docdailey/bobcat-300/img/bobcat-neo-pinmap.png

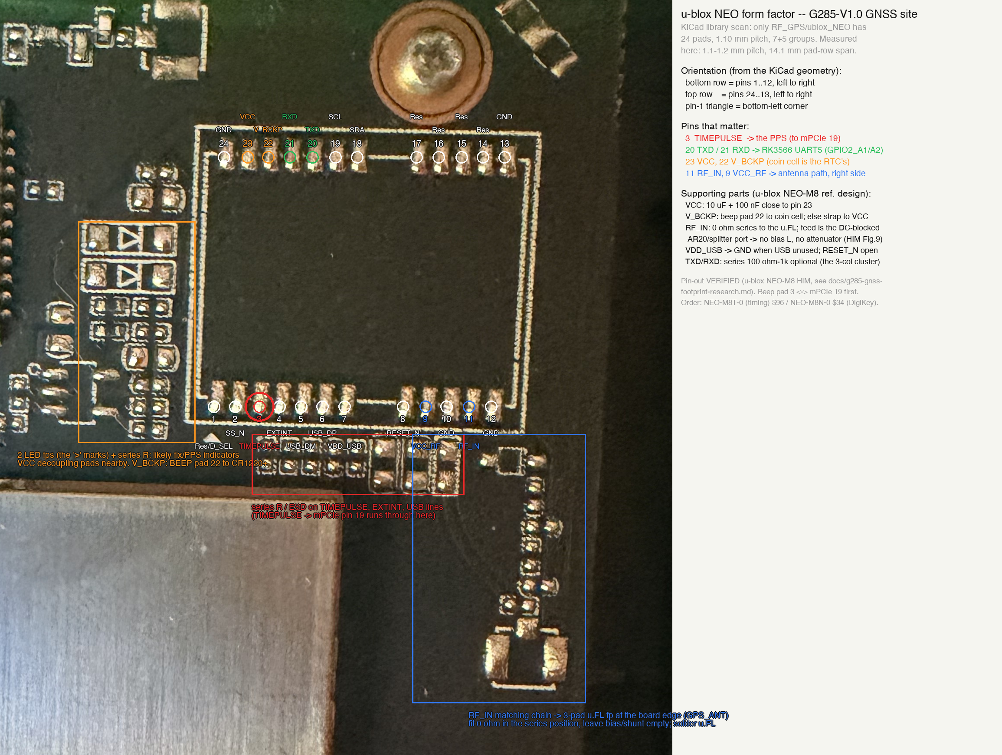
img/bobcat-neo-pinmap.png
