docdailey/bobcat-300/img/bobcat-placement-map.png

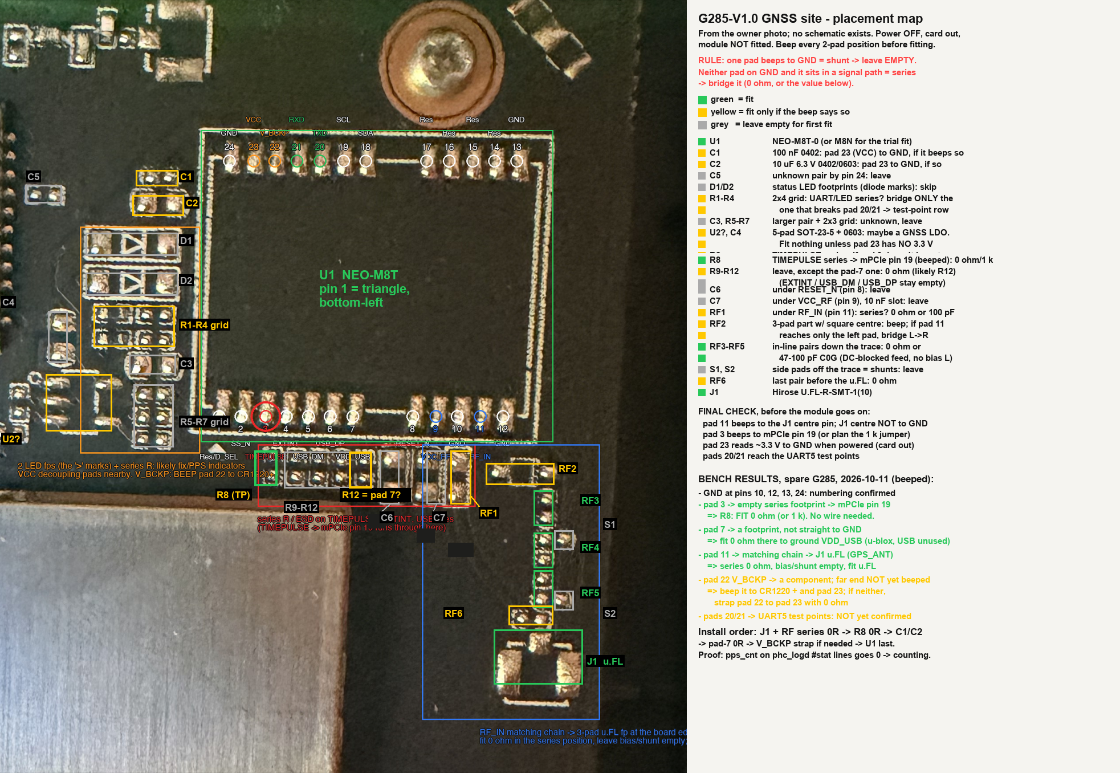
img/bobcat-placement-map.png
