docdailey/bobcat-300/img/socket-resistor-column.jpg

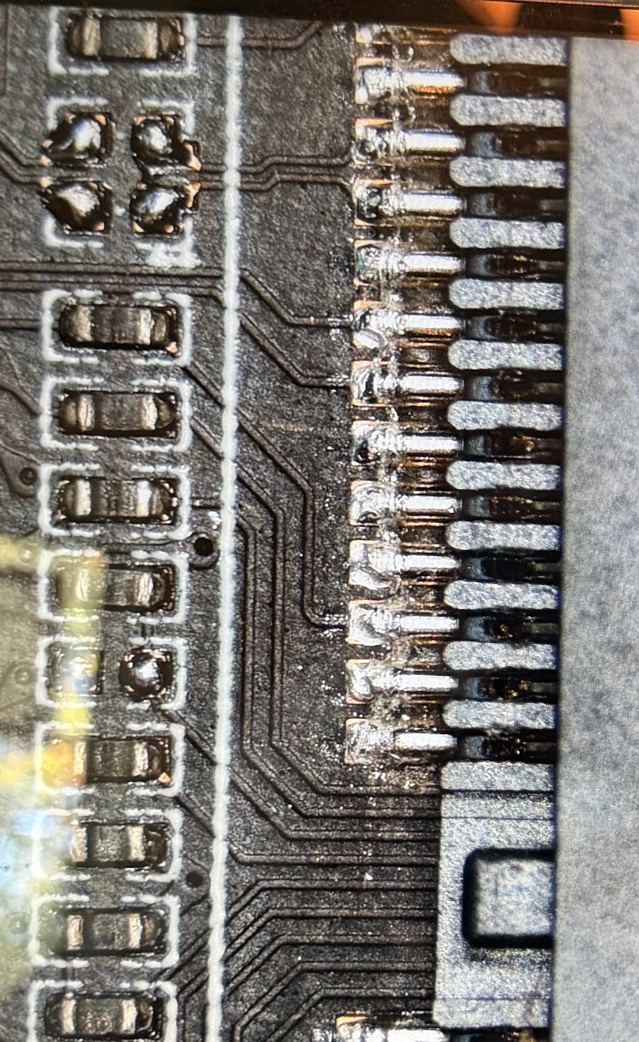
img/socket-resistor-column.jpg
