docdailey/bobcat-300/img/socket-tail-map.png

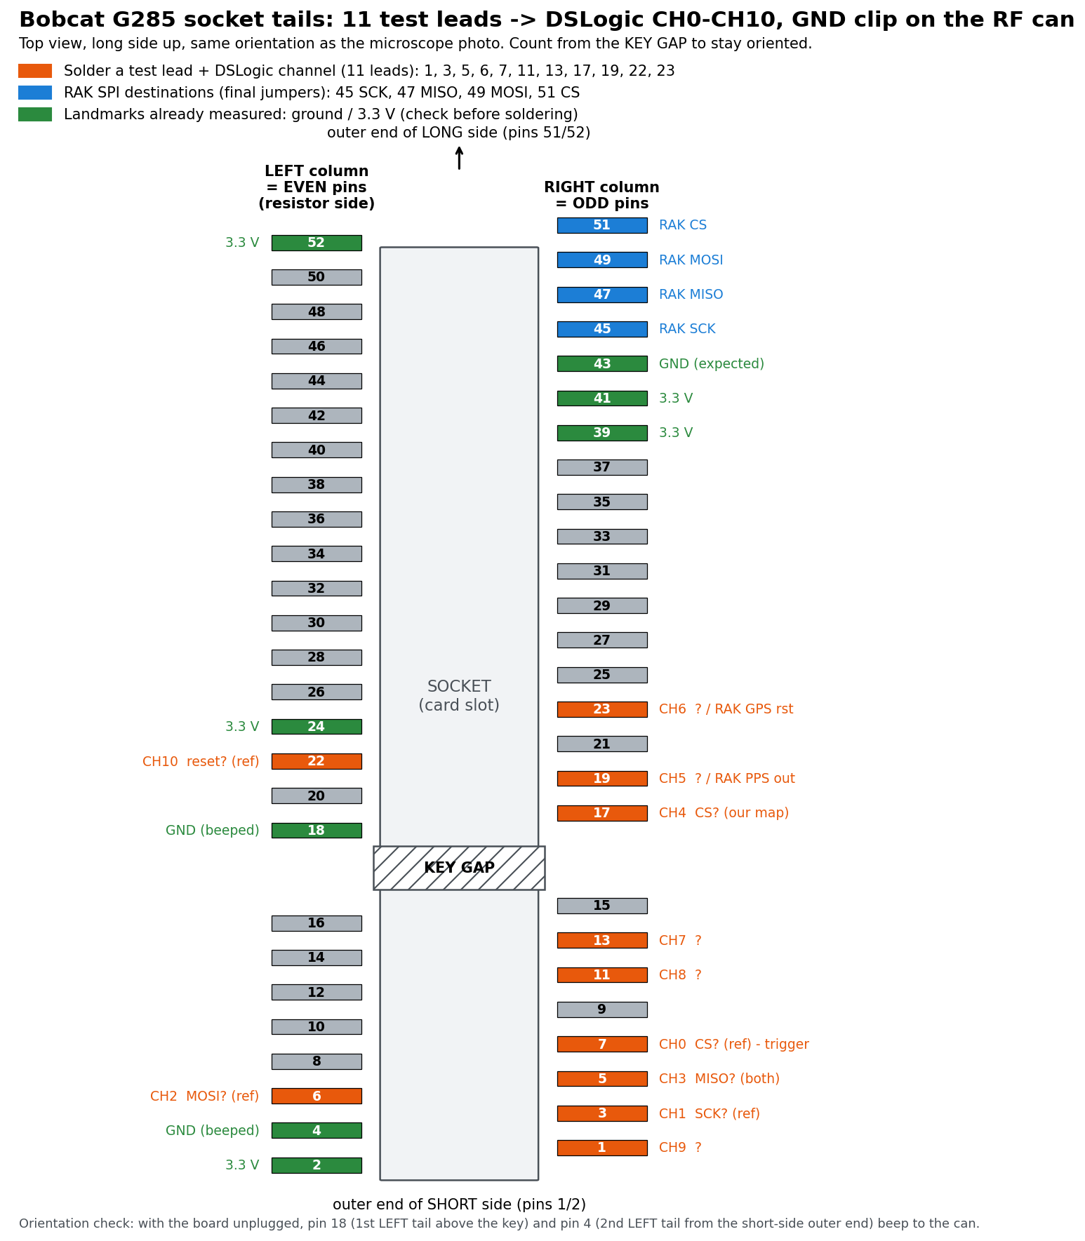
img/socket-tail-map.png
