docdailey/bobcat-300/interposer-rev-a/renders/bobcat-rak-interposer-3d-bottom.png

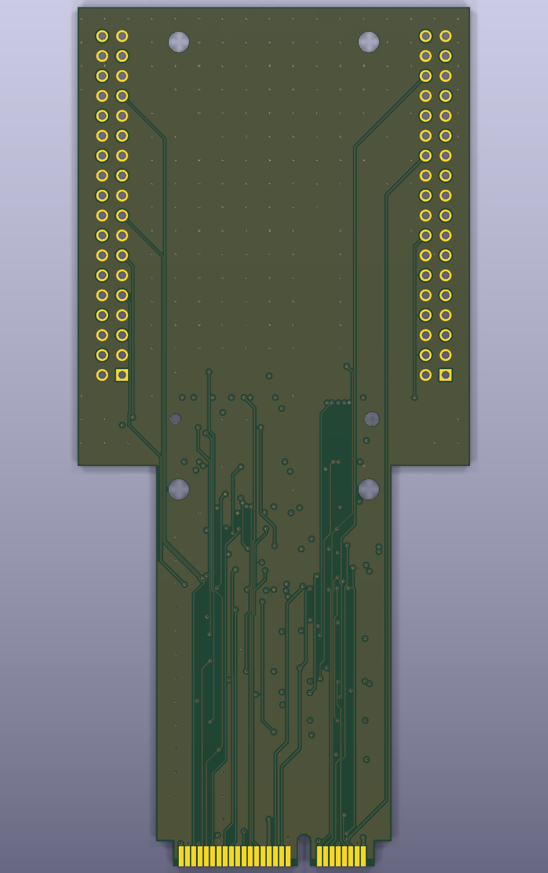
interposer-rev-a/renders/bobcat-rak-interposer-3d-bottom.png
