docdailey/bobcat-300/interposer-rev-a/renders/bobcat-rak-interposer-3d-top.png

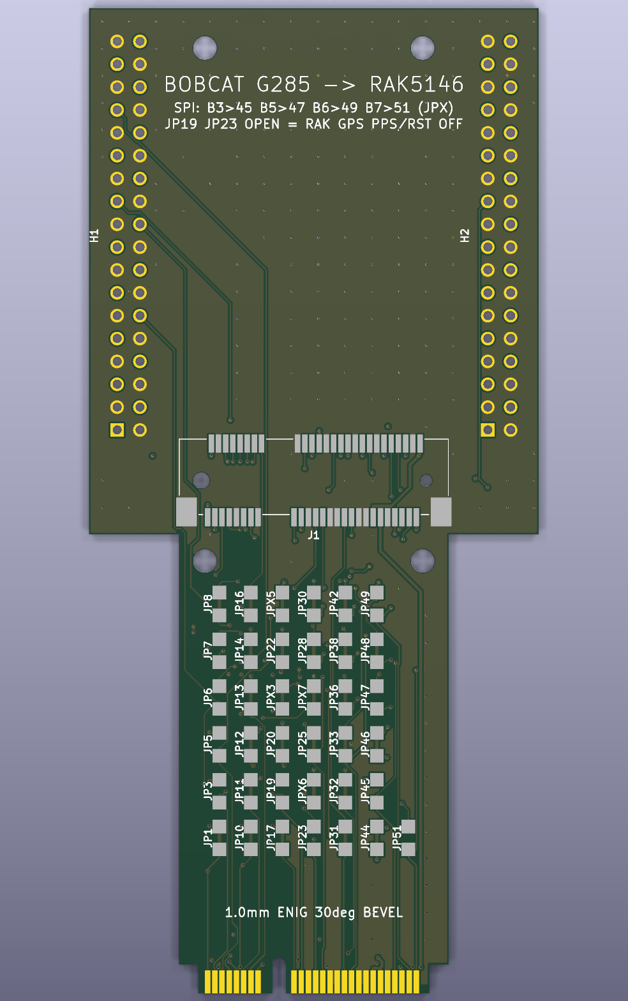
interposer-rev-a/renders/bobcat-rak-interposer-3d-top.png
