docdailey/bobcat-300/interposer-rev-a/renders/bobcat-rak-interposer-pcb-bottom.png

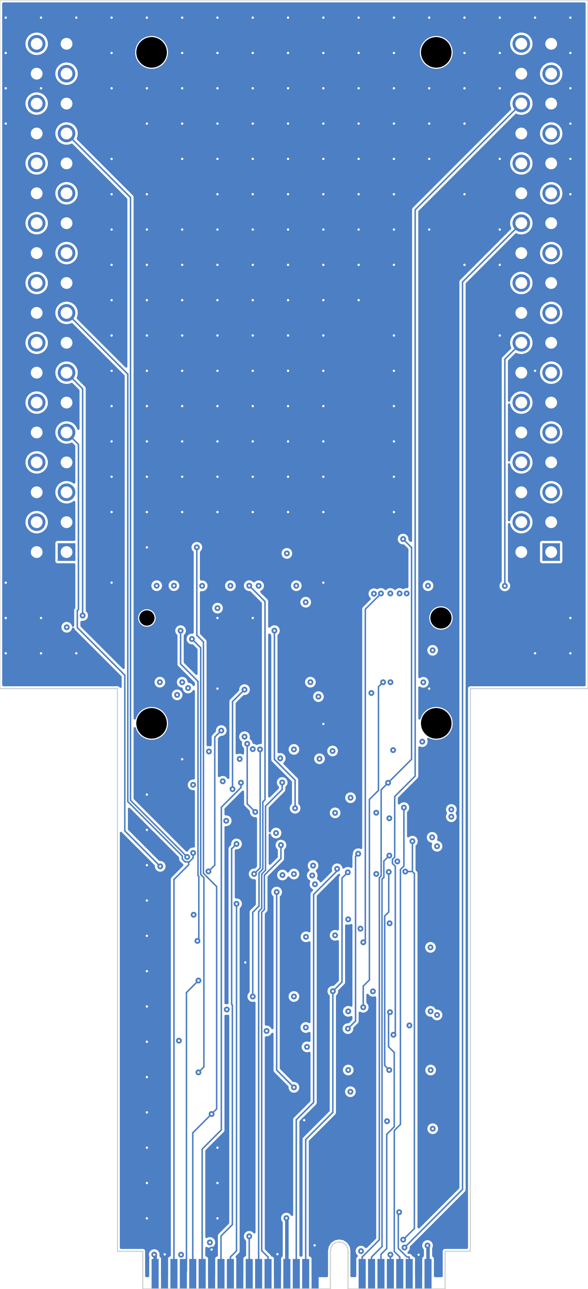
interposer-rev-a/renders/bobcat-rak-interposer-pcb-bottom.png
