docdailey/bobcat-300/interposer-rev-a/renders/bobcat-rak-interposer-pcb-in1-gnd.png

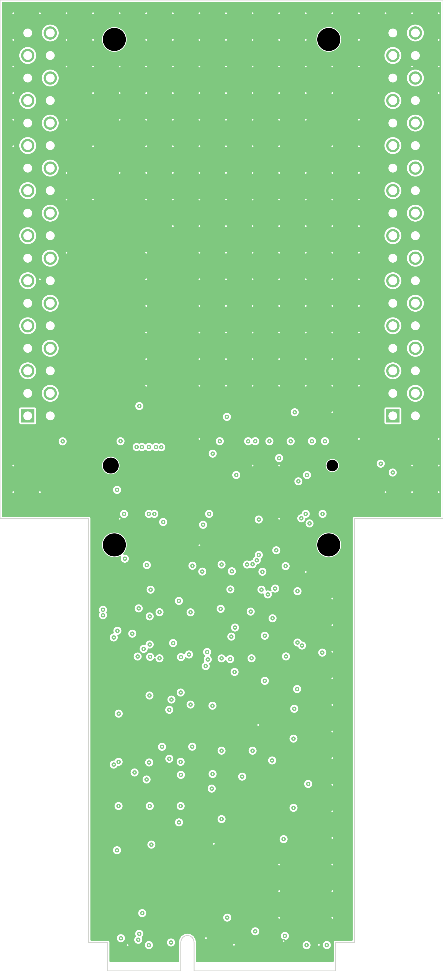
interposer-rev-a/renders/bobcat-rak-interposer-pcb-in1-gnd.png
