docdailey/bobcat-300/interposer-rev-a/renders/bobcat-rak-interposer-pcb-top.png

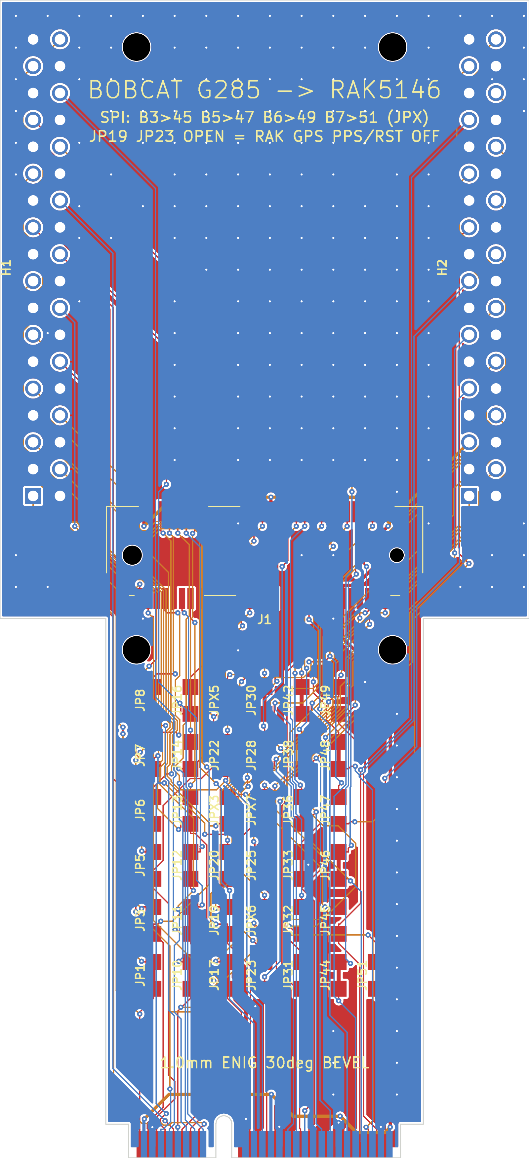
interposer-rev-a/renders/bobcat-rak-interposer-pcb-top.png
