docdailey/bobcat-300/interposer-rev-a/renders/bobcat-rak-interposer-schematic.png

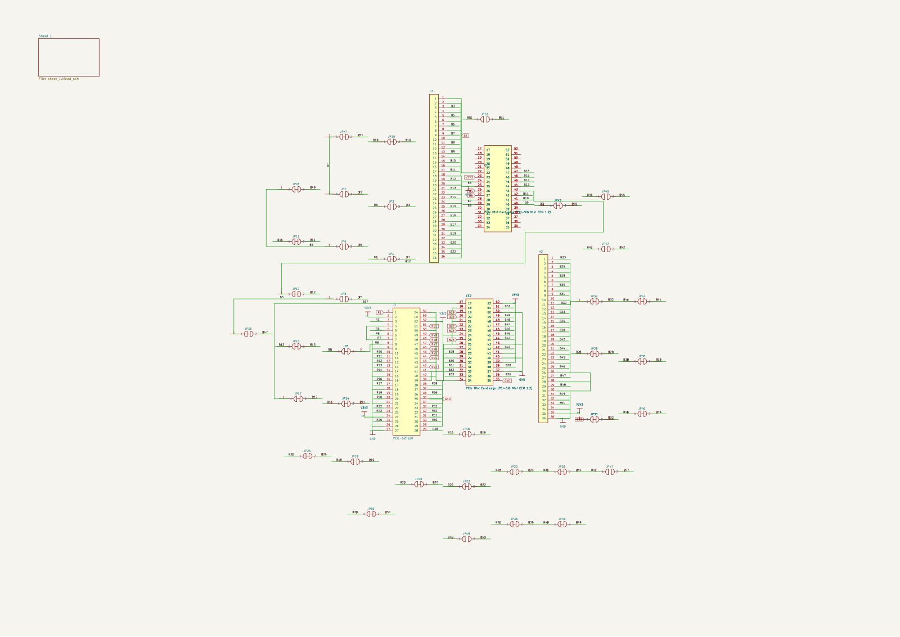
interposer-rev-a/renders/bobcat-rak-interposer-schematic.png
