docdailey/bobcat-300/stack-adapter/fab/panel/bobcat-rak-stack-adapter-panel-3d-top.png

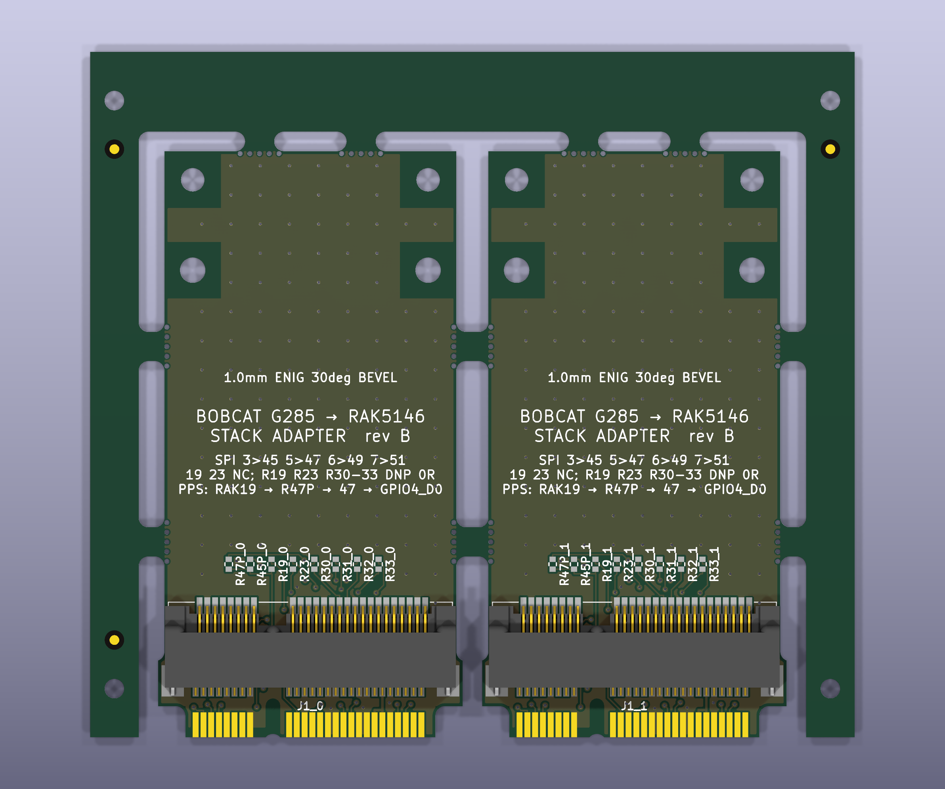
stack-adapter/fab/panel/bobcat-rak-stack-adapter-panel-3d-top.png
