docdailey/bobcat-300/stack-adapter/fab/panel/bobcat-rak-stack-adapter-panel-top.png

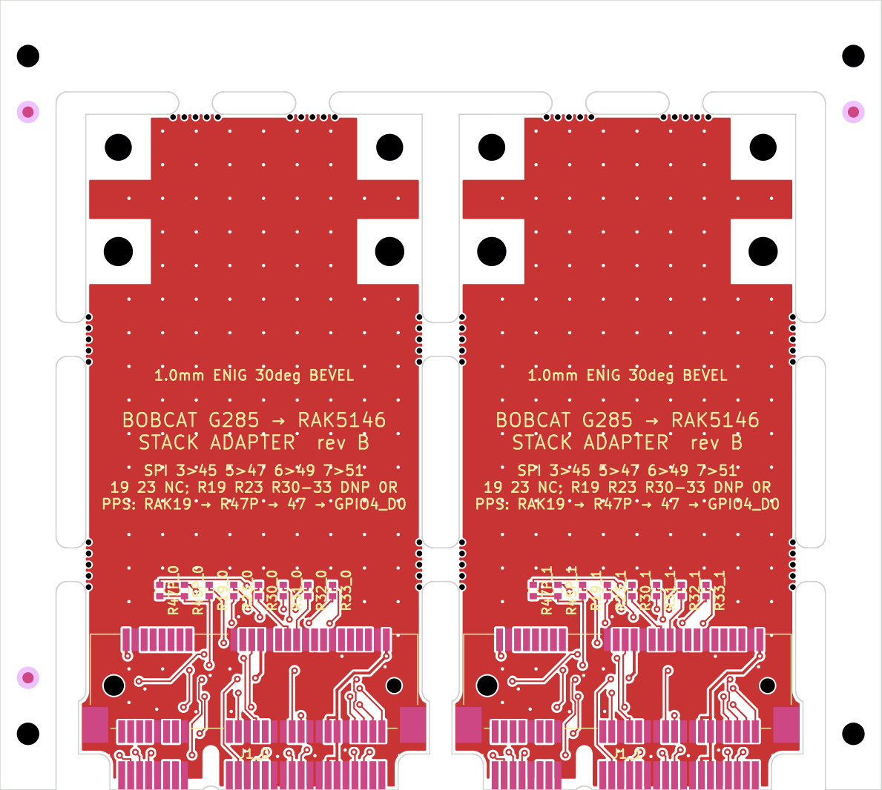
stack-adapter/fab/panel/bobcat-rak-stack-adapter-panel-top.png
