docdailey/bobcat-300/stack-adapter/renders/bobcat-rak-stack-adapter-3d-bottom.png

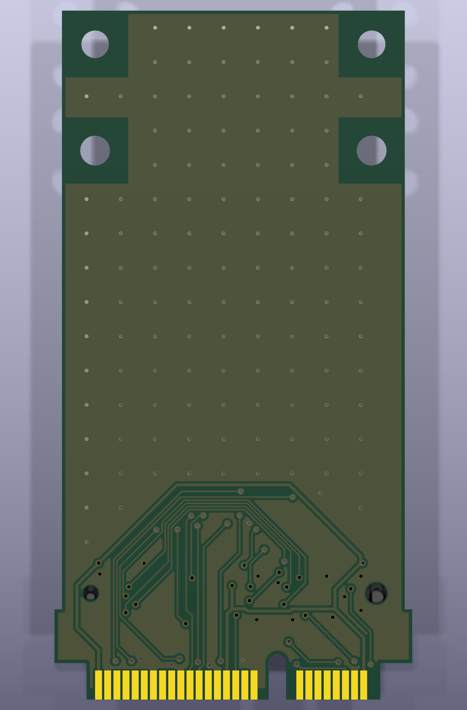
stack-adapter/renders/bobcat-rak-stack-adapter-3d-bottom.png
