docdailey/bobcat-300/stack-adapter/renders/bobcat-rak-stack-adapter-3d-top.png

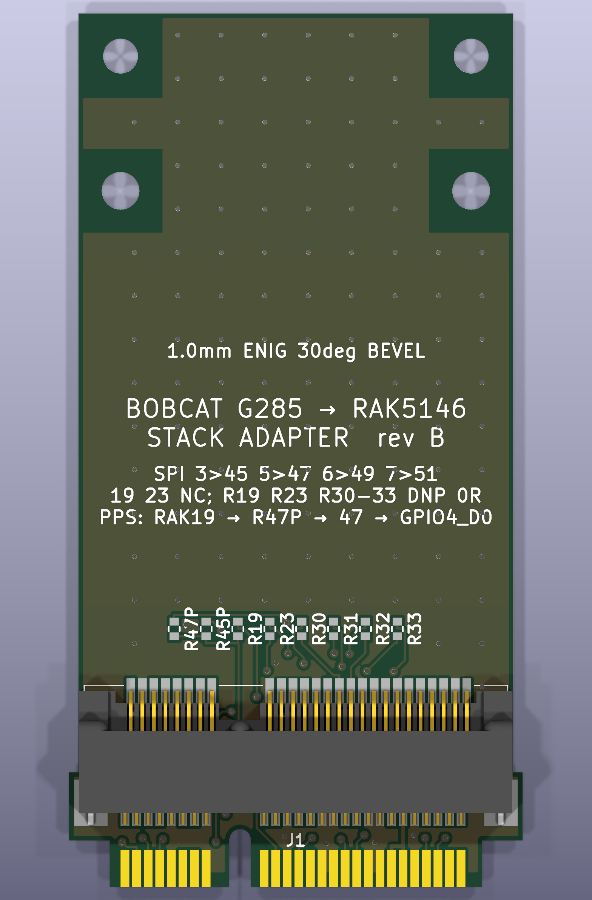
stack-adapter/renders/bobcat-rak-stack-adapter-3d-top.png
