docdailey/bobcat-300/stack-adapter/renders/bobcat-rak-stack-adapter-pcb-bottom.png

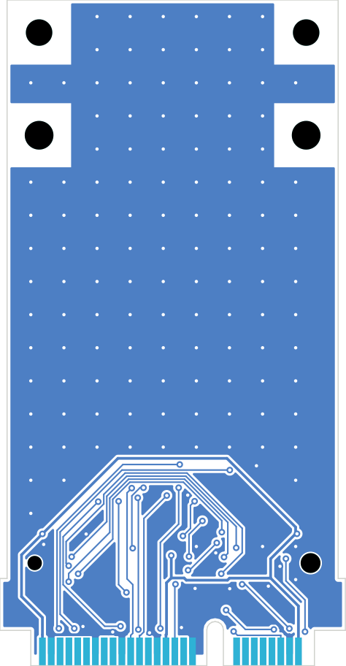
stack-adapter/renders/bobcat-rak-stack-adapter-pcb-bottom.png
