docdailey/bobcat-300/stack-adapter/renders/bobcat-rak-stack-adapter-pcb-top.png

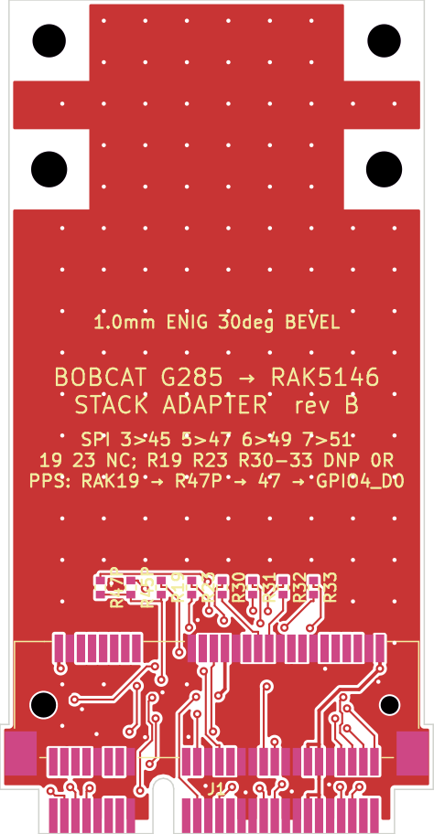
stack-adapter/renders/bobcat-rak-stack-adapter-pcb-top.png
