docdailey/bobcat-300/stack-adapter/renders/bobcat-rak-stack-adapter-schematic.png

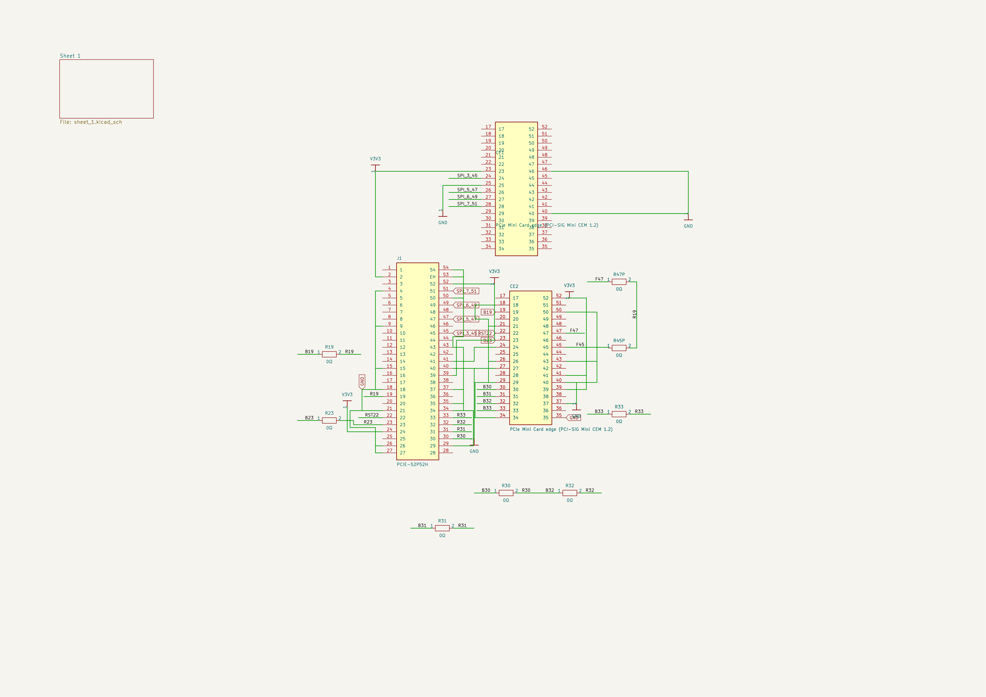
stack-adapter/renders/bobcat-rak-stack-adapter-schematic.png
