docdailey/bobcat-300/stack-adapter/fab/bobcat-rak-stack-adapter-bom.csv

Comment | Designator | Footprint | LCSC | Manufacturer | MPN | Qty | Populate
PCIE-52P52H Mini PCIe socket | J1 | PCIE-52P52H | C444927 | SOFNG | PCIE-52P52H | 1 | yes
0R 0402 (GPS PPS: RAK 19 -> finger 47) | R47P | 0402 | C17168 | UNI-ROYAL | 0402WGF0000TCE | 1 | yes
0R 0402 (option links, DNP) | R19,R23,R30,R31,R32,R33,R45P | 0402 | C17168 | UNI-ROYAL | 0402WGF0000TCE | 7 | no (DNP)
