docdailey/bobcat-300/stack-adapter/fab/panel/bobcat-rak-stack-adapter-panel-bom.csv

Comment | Designator | Footprint | LCSC Part #
PCIE-52P52H Mini PCIe socket | J1_0,J1_1 | PCIE-52P52H | C444927
0R 0402 | R47P_0,R47P_1 | 0402 | C17168
