docdailey/bobcat-300/interposer-rev-a/fab/bobcat-rak-interposer-bom.csv

Designator | Value | MPN | Manufacturer | LCSC | Qty
J1 | PCIE-52P52H | PCIE-52P52H | SOFNG | C444927 | 1
