docdailey/bobcat-300/stack-adapter/kicad/3dmodels/PCIE-52P52H_C444927.step

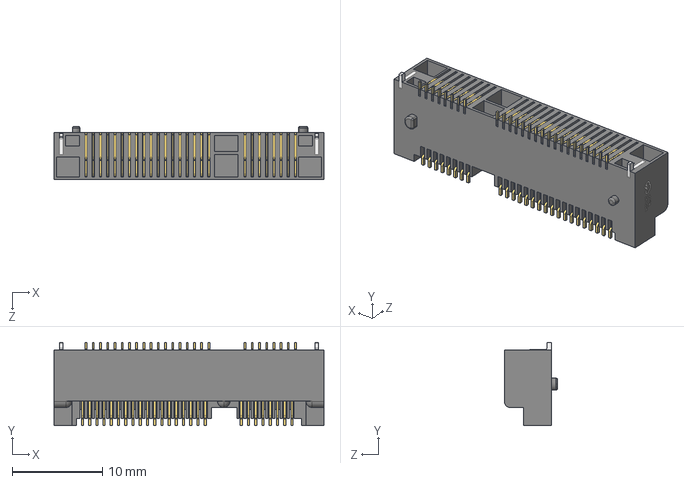
[picture p21: CAD file, 2026-10-23]
stack-adapter/kicad/3dmodels/PCIE-52P52H_C444927.step
29.9 x 9.22 x 5.90 mm
