docdailey/bobcat-300/stack-adapter/renders/bobcat-rak-stack-adapter-1to1-fitcheck.pdf

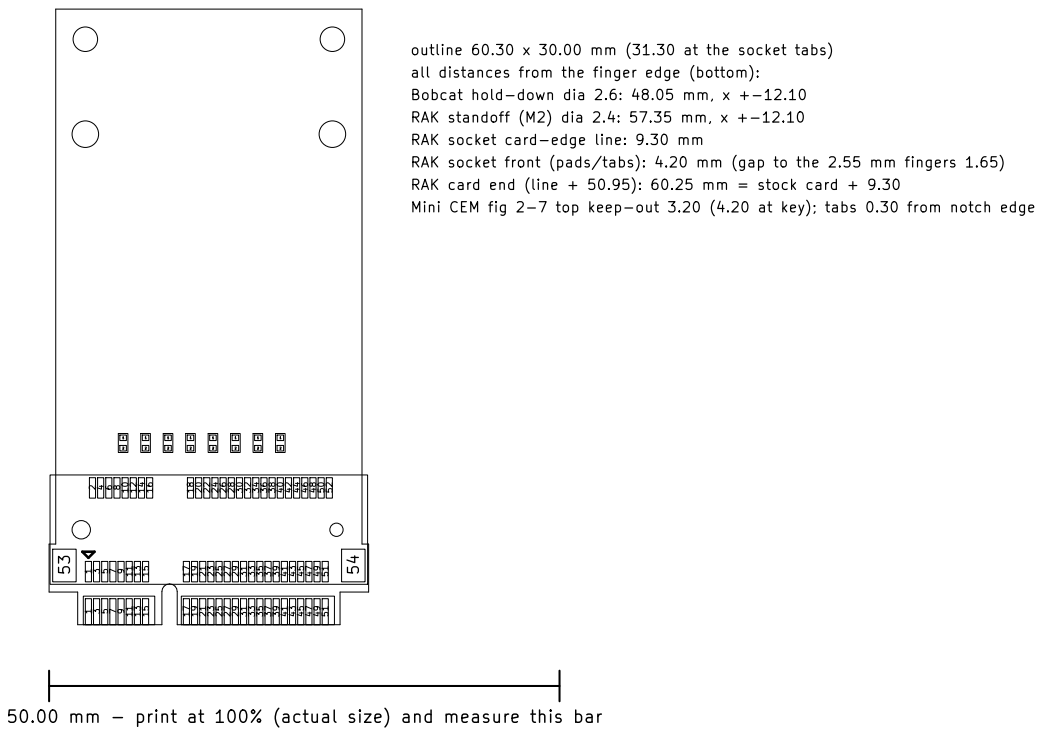
[picture p22: page 1]

RAK socket front (pads/tabs): 4.20 mm (gap to the 2.55 mm fingers 1.65) RAK card end (line + 50.95): 60.25 mm = stock card + 9.30 Mini CEM fig 2-7 top keep-out 3.20 (4.20 at key); tabs 0.30 from notch edge 50.00 mm - print at 100% (actual size) and measure this bar

Sheet:
File: bobcat-rak-stack-adapter.kicad_pcb
Title:

Size: A4 | Rev:
KiCad E.D.A. 10.0.4 | Id: 1/1
