docdailey/bobcat-300/stack-adapter/kicad/bobcat-rak-stack-adapter.kicad_pcb

## KiCad design stack-adapter/kicad/bobcat-rak-stack-adapter.kicad_pcb (2026-10-23)

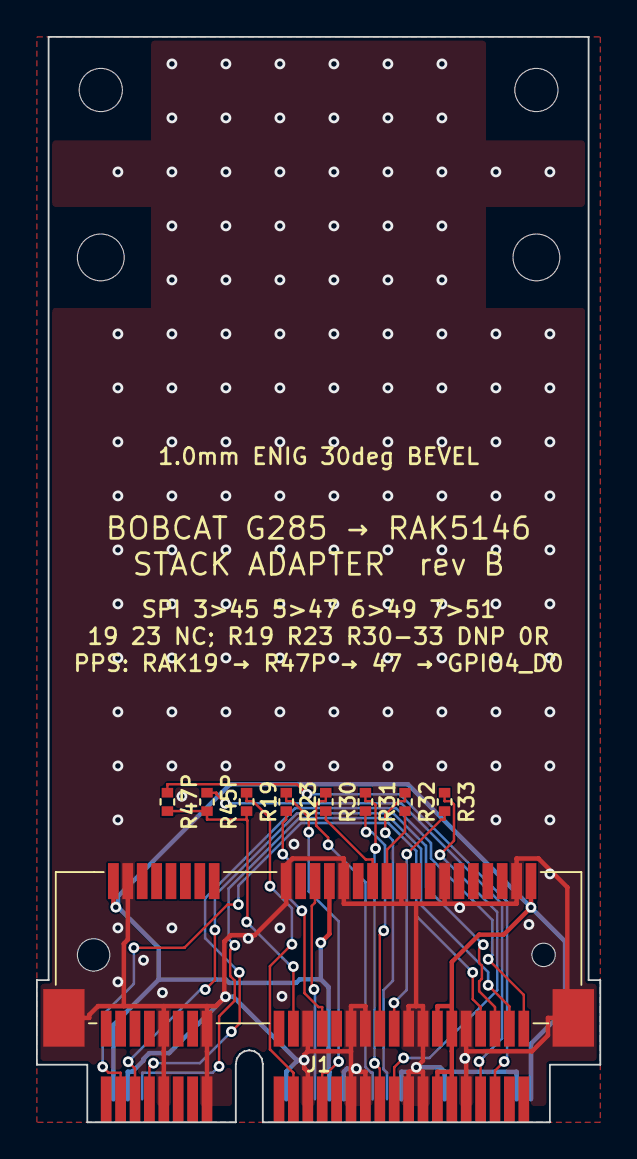
[picture p23: board bobcat-rak-stack-adapter.kicad_pcb from above]

Board: 2 copper layers, 31.3 x 60.3 mm, 15 parts (0 on the bottom side), 21 nets.

Parts:
CE1, CE2: card edge; PCIe_Mini_Card_edge_PCI-SIG_Mini_CEM_1_2
J1: PCIE-52P52H
MH1, MH2: Bobcat hold-down 2.6mm; hole_circle_holeDiameter2.6mm
MH3, MH4: RAK standoff M2 2.4mm; hole_circle_holeDiameter2.4mm
R19, R23, R30, R31, R32, R33, R45P: 0R DNP; resistor_res0402
R47P: 0R; resistor_res0402

Connections:
B19: CE2.19, R19.1
B23: CE2.23, R23.1
B30: CE2.30, R30.1
B31: CE2.31, R31.1
B32: CE2.32, R32.1
B33: CE2.33, R33.1
F45: CE2.45, R45P.1
F47: CE2.47, R47P.1
GND: CE1.4, CE1.9, CE1.15, CE2.18, CE2.21, CE2.26, CE2.27, CE2.29, CE2.34, CE2.35, CE2.37, CE2.40, CE2.43, CE2.50, J1.4, J1.9, J1.15, J1.18, J1.21, J1.26, J1.27, J1.29, J1.34, J1.35, J1.37, J1.40, J1.43, J1.50, J1.53, J1.54
R19: J1.19, R19.2, R45P.2, R47P.2
R23: J1.23, R23.2
R30: J1.30, R30.2
R31: J1.31, R31.2
R32: J1.32, R32.2
R33: J1.33, R33.2
RST22: CE2.22, J1.22
SPI_3_45: CE1.3, J1.45
SPI_5_47: CE1.5, J1.47
SPI_6_49: CE1.6, J1.49
SPI_7_51: CE1.7, J1.51
V3V3: CE1.2, CE2.24, CE2.39, CE2.41, CE2.52, J1.2, J1.24, J1.39, J1.41, J1.52
