docdailey/bobcat-300/interposer-rev-a/kicad/bobcat-rak-interposer.kicad_pcb

## KiCad design interposer-rev-a/kicad/bobcat-rak-interposer.kicad_pcb (2026-10-23)

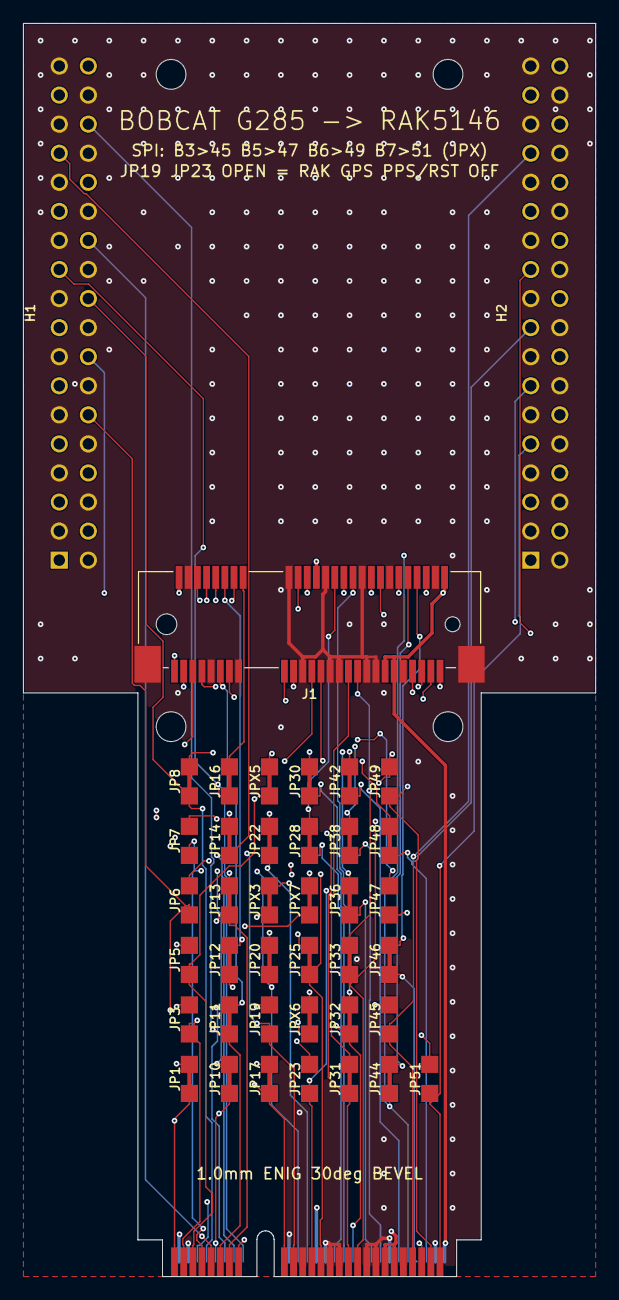
[picture p24: board bobcat-rak-interposer.kicad_pcb from above]

Board: 4 copper layers, 50.0 x 109.5 mm, 46 parts (0 on the bottom side), 70 nets.

Parts:
CE1, CE2: card edge; PCIe_Mini_Card_edge_PCI-SIG_Mini_CEM_1_2
H1, H2: 2x18 2.54mm header (unpopulated); pin_header_pinrow36_p2_54_nopinlabels_rows2
J1: PCIE-52P52H
JP1, JP8, JP10, JP11, JP12, JP13, JP14, JP16, JP17, JP20, JP22, JP25, JP28, JP30, JP31, JP32, JP33, JP36, JP38, JP42, JP44, JP46, JP48: solder jumper; chip_solderjumper2_bridged12
JP3, JP5, JP6, JP7, JP19, JP23, JP45, JP47, JP49, JP51: solder jumper; chip_solderjumper2
JPX3, JPX5, JPX6, JPX7: solder jumper; chip_solderjumper2_bridged12
MH1, MH2, MH3, MH4: MountingHole 2.6mm; hole_circle_holeDiameter2.6mm

Connections:
B1: CE1.1, H1.1, JP1.1
B3: CE1.3, H1.3, JP3.1, JPX3.1
B5: CE1.5, H1.5, JP5.1, JPX5.1
B6: CE1.6, H1.7, JP6.1, JPX6.1
B7: CE1.7, H1.9, JP7.1, JPX7.1
B8: CE1.8, H1.11, JP8.1
B9: CE1.9, H1.13
B10: CE1.10, H1.15, JP10.1
B11: CE1.11, H1.17, JP11.1
B12: CE1.12, H1.19, JP12.1
B13: CE1.13, H1.21, JP13.1
B14: CE1.14, H1.23, JP14.1
B15: CE1.15, H1.25
B16: CE1.16, H1.27, JP16.1
B17: CE2.17, H1.29, JP17.1
B19: CE2.19, H1.31, JP19.1
B20: CE2.20, H1.33, JP20.1
B22: CE2.22, H1.35, JP22.1
B23: CE2.23, H2.1, JP23.1
B25: CE2.25, H2.3, JP25.1
B28: CE2.28, H2.5, JP28.1
B30: CE2.30, H2.7, JP30.1
B31: CE2.31, H2.9, JP31.1
B32: CE2.32, H2.11, JP32.1
B33: CE2.33, H2.13, JP33.1
B36: CE2.36, H2.15, JP36.1
B38: CE2.38, H2.17, JP38.1
B42: CE2.42, H2.19, JP42.1
B44: CE2.44, H2.21, JP44.1
B45: CE2.45, H2.23, JP45.1
B46: CE2.46, H2.25, JP46.1
B47: CE2.47, H2.27, JP47.1
B48: CE2.48, H2.29, JP48.1
B49: CE2.49, H2.31, JP49.1
B51: CE2.51, H2.33, JP51.1
GND: CE1.4, CE2.18, CE2.21, CE2.26, CE2.27, CE2.29, CE2.34, CE2.35, CE2.37, CE2.40, CE2.43, CE2.50, H1.2, H1.4, H1.6, H1.8, H1.10, H1.12, H1.14, H1.16, H1.18, H1.20, H1.22, H1.24, H1.26, H1.28, H1.30, H1.32, H1.34, H1.36, H2.2, H2.4, H2.6, H2.8, H2.10, H2.12, H2.14, H2.16, H2.18, H2.20, H2.22, H2.24, H2.26, H2.28, H2.30, H2.32, H2.34, H2.36, J1.4, J1.9, J1.15, J1.18, J1.21, J1.26, J1.27, J1.29, J1.34, J1.35, J1.37, J1.40, J1.43, J1.50, J1.53, J1.54
R1: J1.1, JP1.2
R3: J1.3, JP3.2
R5: J1.5, JP5.2
R6: J1.6, JP6.2
R7: J1.7, JP7.2
R8: J1.8, JP8.2
R10: J1.10, JP10.2
R11: J1.11, JP11.2
R12: J1.12, JP12.2
R13: J1.13, JP13.2
R14: J1.14, JP14.2
R16: J1.16, JP16.2
R17: J1.17, JP17.2
R19: J1.19, JP19.2
R20: J1.20, JP20.2
R22: J1.22, JP22.2
R23: J1.23, JP23.2
R25: J1.25, JP25.2
R28: J1.28, JP28.2
R30: J1.30, JP30.2
R31: J1.31, JP31.2
R32: J1.32, JP32.2
R33: J1.33, JP33.2
R36: J1.36, JP36.2
R38: J1.38, JP38.2
R42: J1.42, JP42.2
R44: J1.44, JP44.2
R45: J1.45, JP45.2, JPX3.2
R46: J1.46, JP46.2
R47: J1.47, JP47.2, JPX5.2
R48: J1.48, JP48.2
R49: J1.49, JP49.2, JPX6.2
R51: J1.51, JP51.2, JPX7.2
V3V3: CE1.2, CE2.24, CE2.39, CE2.41, CE2.52, H2.35, J1.2, J1.24, J1.39, J1.41, J1.52
