docdailey/bobcat-300/stack-adapter/fab/panel/bobcat-rak-stack-adapter-panel.kicad_pcb

## KiCad design stack-adapter/fab/panel/bobcat-rak-stack-adapter-panel.kicad_pcb (2026-10-23)

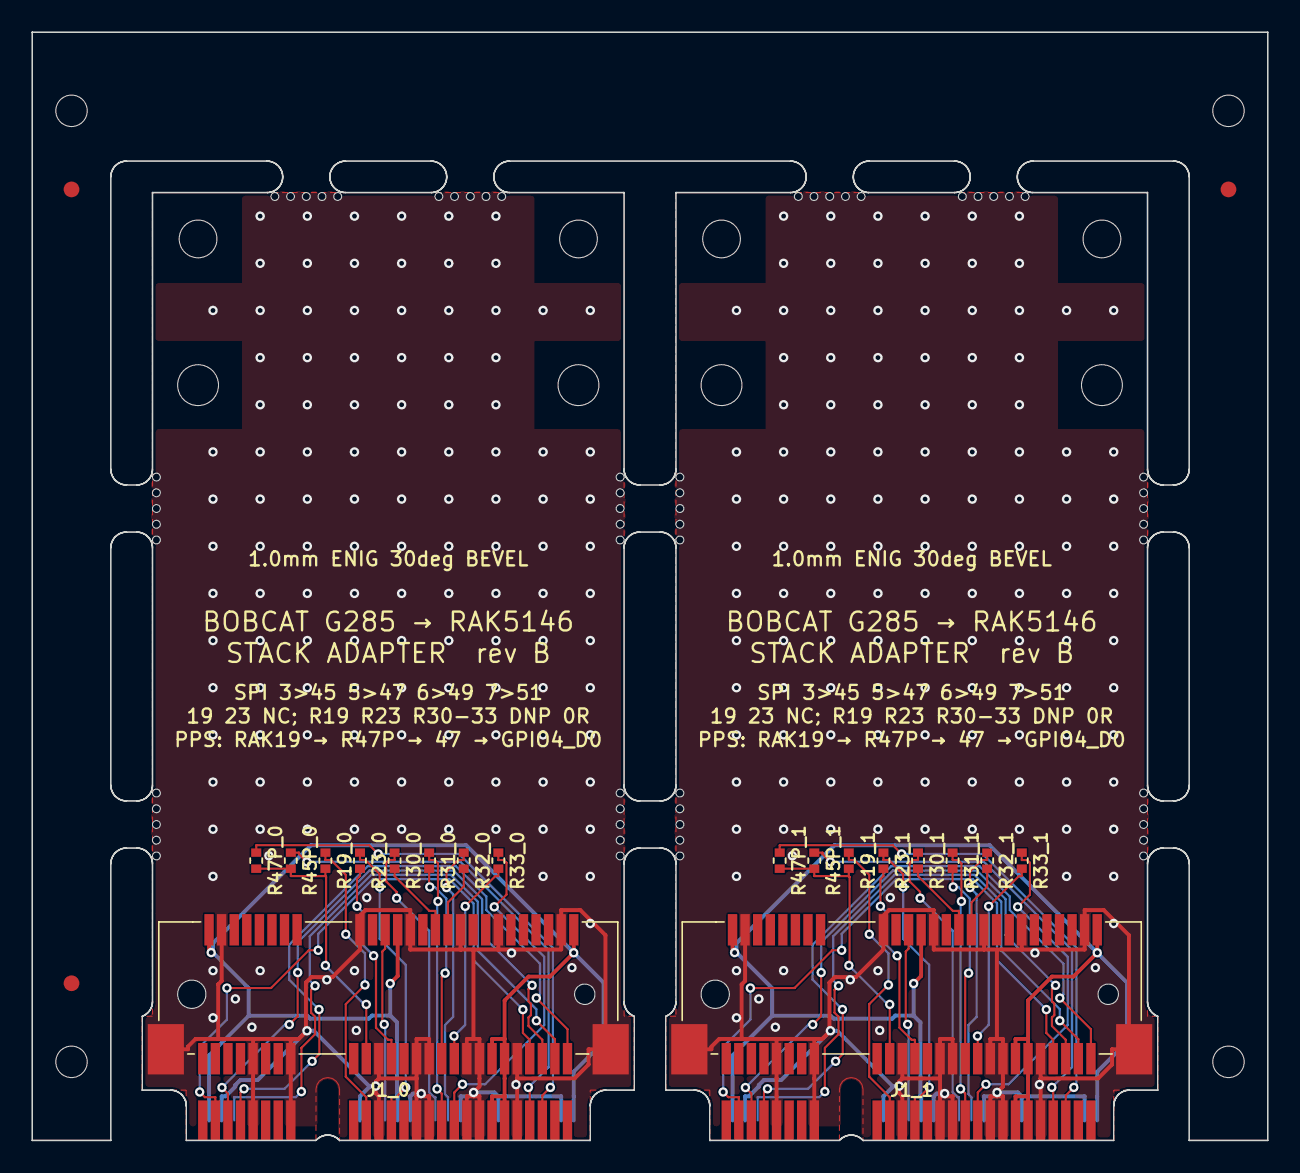
[picture p25: board bobcat-rak-stack-adapter-panel.kicad_pcb from above]

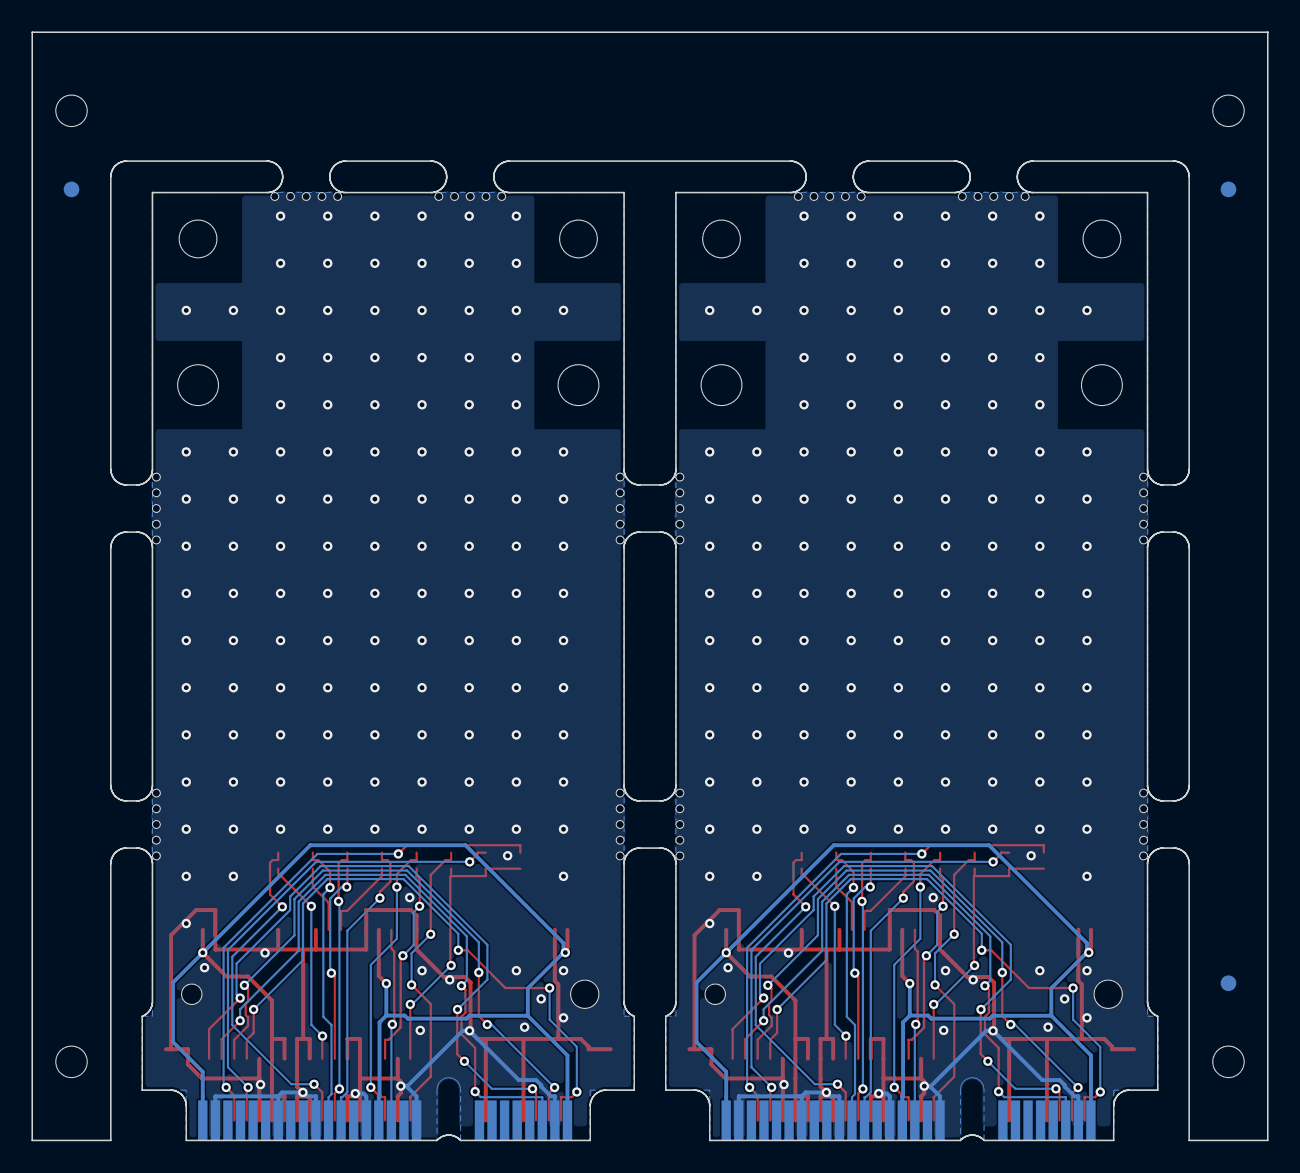
[picture p26: board bobcat-rak-stack-adapter-panel.kicad_pcb from below]

Board: 2 copper layers, 78.6 x 70.5 mm, 100 parts (3 on the bottom side), 42 nets.

Parts:
CE1_0, CE1_1, CE2_0, CE2_1: card edge; PCIe_Mini_Card_edge_PCI-SIG_Mini_CEM_1_2
J1_0, J1_1: PCIE-52P52H
KiKit_FID_B_1, KiKit_FID_B_2, KiKit_FID_B_3: Fiducial
KiKit_FID_T_1, KiKit_FID_T_2, KiKit_FID_T_3: Fiducial
KiKit_MB_1_1, KiKit_MB_1_2, KiKit_MB_1_3, KiKit_MB_1_4, KiKit_MB_1_5, KiKit_MB_2_1, KiKit_MB_2_2, KiKit_MB_2_3, KiKit_MB_2_4, KiKit_MB_2_5, KiKit_MB_3_1, KiKit_MB_3_2, KiKit_MB_3_3, KiKit_MB_3_4, KiKit_MB_3_5, KiKit_MB_4_1, KiKit_MB_4_2, KiKit_MB_4_3, KiKit_MB_4_4, KiKit_MB_4_5, KiKit_MB_5_1, KiKit_MB_5_2, KiKit_MB_5_3, KiKit_MB_5_4, KiKit_MB_5_5, KiKit_MB_6_1, KiKit_MB_6_2, KiKit_MB_6_3, KiKit_MB_6_4, KiKit_MB_6_5, KiKit_MB_7_1, KiKit_MB_7_2, KiKit_MB_7_3, KiKit_MB_7_4, KiKit_MB_7_5, KiKit_MB_8_1, KiKit_MB_8_2, KiKit_MB_8_3, KiKit_MB_8_4, KiKit_MB_8_5, KiKit_MB_9_1, KiKit_MB_9_2, KiKit_MB_9_3, KiKit_MB_9_4, KiKit_MB_9_5, KiKit_MB_10_1, KiKit_MB_10_2, KiKit_MB_10_3, KiKit_MB_10_4, KiKit_MB_10_5, KiKit_MB_11_1, KiKit_MB_11_2, KiKit_MB_11_3, KiKit_MB_11_4, KiKit_MB_11_5, KiKit_MB_12_1, KiKit_MB_12_2, KiKit_MB_12_3, KiKit_MB_12_4, KiKit_MB_12_5: NPTH
KiKit_TO_1, KiKit_TO_2, KiKit_TO_3, KiKit_TO_4: NPTH
MH1_0, MH1_1, MH2_0, MH2_1: Bobcat hold-down 2.6mm; hole_circle_holeDiameter2.6mm
MH3_0, MH3_1, MH4_0, MH4_1: RAK standoff M2 2.4mm; hole_circle_holeDiameter2.4mm
R19_0, R19_1, R23_0, R23_1, R30_0, R30_1, R31_0, R31_1, R32_0, R32_1, R33_0, R33_1, R45P_0, R45P_1: 0R DNP; resistor_res0402
R47P_0, R47P_1: 0R; resistor_res0402

Connections:
Board_0-B19: CE2_0.19, R19_0.1
Board_0-B23: CE2_0.23, R23_0.1
Board_0-B30: CE2_0.30, R30_0.1
Board_0-B31: CE2_0.31, R31_0.1
Board_0-B32: CE2_0.32, R32_0.1
Board_0-B33: CE2_0.33, R33_0.1
Board_0-F45: CE2_0.45, R45P_0.1
Board_0-F47: CE2_0.47, R47P_0.1
Board_0-GND: CE1_0.4, CE1_0.9, CE1_0.15, CE2_0.18, CE2_0.21, CE2_0.26, CE2_0.27, CE2_0.29, CE2_0.34, CE2_0.35, CE2_0.37, CE2_0.40, CE2_0.43, CE2_0.50, J1_0.4, J1_0.9, J1_0.15, J1_0.18, J1_0.21, J1_0.26, J1_0.27, J1_0.29, J1_0.34, J1_0.35, J1_0.37, J1_0.40, J1_0.43, J1_0.50, J1_0.53, J1_0.54
Board_0-R19: J1_0.19, R19_0.2, R45P_0.2, R47P_0.2
Board_0-R23: J1_0.23, R23_0.2
Board_0-R30: J1_0.30, R30_0.2
Board_0-R31: J1_0.31, R31_0.2
Board_0-R32: J1_0.32, R32_0.2
Board_0-R33: J1_0.33, R33_0.2
Board_0-RST22: CE2_0.22, J1_0.22
Board_0-SPI_3_45: CE1_0.3, J1_0.45
Board_0-SPI_5_47: CE1_0.5, J1_0.47
Board_0-SPI_6_49: CE1_0.6, J1_0.49
Board_0-SPI_7_51: CE1_0.7, J1_0.51
Board_0-V3V3: CE1_0.2, CE2_0.24, CE2_0.39, CE2_0.41, CE2_0.52, J1_0.2, J1_0.24, J1_0.39, J1_0.41, J1_0.52
Board_1-B19: CE2_1.19, R19_1.1
Board_1-B23: CE2_1.23, R23_1.1
Board_1-B30: CE2_1.30, R30_1.1
Board_1-B31: CE2_1.31, R31_1.1
Board_1-B32: CE2_1.32, R32_1.1
Board_1-B33: CE2_1.33, R33_1.1
Board_1-F45: CE2_1.45, R45P_1.1
Board_1-F47: CE2_1.47, R47P_1.1
Board_1-GND: CE1_1.4, CE1_1.9, CE1_1.15, CE2_1.18, CE2_1.21, CE2_1.26, CE2_1.27, CE2_1.29, CE2_1.34, CE2_1.35, CE2_1.37, CE2_1.40, CE2_1.43, CE2_1.50, J1_1.4, J1_1.9, J1_1.15, J1_1.18, J1_1.21, J1_1.26, J1_1.27, J1_1.29, J1_1.34, J1_1.35, J1_1.37, J1_1.40, J1_1.43, J1_1.50, J1_1.53, J1_1.54
Board_1-R19: J1_1.19, R19_1.2, R45P_1.2, R47P_1.2
Board_1-R23: J1_1.23, R23_1.2
Board_1-R30: J1_1.30, R30_1.2
Board_1-R31: J1_1.31, R31_1.2
Board_1-R32: J1_1.32, R32_1.2
Board_1-R33: J1_1.33, R33_1.2
Board_1-RST22: CE2_1.22, J1_1.22
Board_1-SPI_3_45: CE1_1.3, J1_1.45
Board_1-SPI_5_47: CE1_1.5, J1_1.47
Board_1-SPI_6_49: CE1_1.6, J1_1.49
Board_1-SPI_7_51: CE1_1.7, J1_1.51
Board_1-V3V3: CE1_1.2, CE2_1.24, CE2_1.39, CE2_1.41, CE2_1.52, J1_1.2, J1_1.24, J1_1.39, J1_1.41, J1_1.52
