docdailey/bobcat-300/(commit log)

2026-10-23 bobcat-300: fact-checked docs on OS/GPIO, bare-metal Rust, GNSS populate, socket pinout + RAK5146 interposer spec
    Every claim is tagged VERIFIED (with primary source), UNVERIFIED or CONTRADICTED.
    Socket SPI pinout (3/5/6/7) proven with logic-analyzer removal tests.
    Claude-Session: https://claude.ai/code/session_01Au7yLXRzrrweJwAkfxbhgS
2026-10-23 interposer: design status (1.0 mm card-edge, socket part, routing state, pre-fab checks)
    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
2026-10-23 interposer: finger orientation verified on a real card (odd contacts on top)
    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
2026-10-23 interposer: second orientation check (pin 15 ground on top face)
    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
2026-10-23 interposer: routed, KiCad-DRC-clean review release (KiCad project, Gerbers, BOM/CPL, renders, pipeline)
    4-layer 1.0 mm card-edge board. Freerouting + scripted fixes; kicad-cli DRC 0 errors / 0 unconnected
    (52 finger edge-clearance findings exempted by the named card_edge override). gerber_check passes
    against the JLCPCB 4-layer card-edge profile. Not yet fabricated or tested.
    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
    [bobcat-rak-interposer-B_Cu.gbr, bobcat-rak-interposer-B_Mask.gbr, bobcat-rak-interposer-B_Paste.gbr, bobcat-rak-interposer-B_Silkscreen.gbr, bobcat-rak-interposer-Edge_Cuts.gbr, bobcat-rak-interposer-F_Cu.gbr, bobcat-rak-interposer-F_Mask.gbr, bobcat-rak-interposer-F_Paste.gbr]
2026-10-23 interposer: 3D renders (kicad-cli raytrace: iso, top, bottom)
    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
2026-10-23 gitignore: KiCad local state and macOS files
    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
2026-10-23 stack-adapter (rev B): compact G285 -> RAK5146 stack adapter; breakout interposer moved to interposer-rev-a
    60.3 x 30 mm, 1.0 mm, 2-layer. Fingers seat in the Bobcat socket (48.05 mm hold-downs); RAK socket
    front at 4.20 mm (Mini CEM top-side keep-out), RAK card seated at 9.30 mm, standoffs at 57.35 mm,
    card end 60.25 mm (limit 67.95 = card + 17 mm measured clearance). SPI 3->45, 5->47, 6->49, 7->51;
    3.3 V/GND/22 through; 19/23 open with DNP 0R options (also 30-33). KiCad DRC 0 errors / 0 unconnected
    (card_edge override on the 52 finger pads). Review release: not fabricated; order as a 2-up panel
    with mouse-bites so JLCPCB can bevel the fingers.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
    [PCIE-52P52H_C444927.step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]
2026-10-23 stack-adapter: GPS PPS to the processor (R47P fitted: RAK 19 -> finger 47 -> GPIO4_D0); docs: PPS/UART/qErr notes
    Adapter: R47P 0R fitted, R45P (-> finger 45 / GPIO4_C7), R19, R23, R30-R33 DNP. Fingers 45/47 are their own
    nets; the RAK's 45/47 come only from the SPI reroute of Bobcat 3/5. KiCad DRC 0 errors / 0 unconnected.
    New docs/pps-uart-qerr.md: PPS path and core-3 capture, IO-voltage evidence, the GPS UART on RAK 31/33
    (unmapped) with mapping method and fallback, and qErr (UBX-TIM-TP) sawtooth correction incl. the SX1303
    latch and mandatory UBX checksum verification.
    Claude-Session: https://claude.ai/code/session_01Au7yLXRzrrweJw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
    [bobcat-rak-stack-adapter-B_Cu.gbl, bobcat-rak-stack-adapter-B_Mask.gbs, bobcat-rak-stack-adapter-B_Paste.gbp, bobcat-rak-stack-adapter-B_Silkscreen.gbo, bobcat-rak-stack-adapter-Edge_Cuts.gm1, bobcat-rak-stack-adapter-F_Cu.gtl, bobcat-rak-stack-adapter-F_Mask.gts, bobcat-rak-stack-adapter-F_Paste.gtp]
2026-10-23 stack-adapter: 2-up JLCPCB panel (78.7 x 60.4 mm, mouse-bites, fingers flush, rails + fiducials) with panel BOM/CPL
    Gold-finger bevel needs >= 50 x 50 mm, so the 30 x 60.3 mm adapter ships 2-up. GND stitching kept >= 1 mm
    from the outline (clears mouse-bites). KiCad DRC 0 errors / 0 unconnected; gerber_check passes incl. size.
    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
    [bobcat-rak-stack-adapter-B_Cu.gbl, bobcat-rak-stack-adapter-B_Mask.gbs, bobcat-rak-stack-adapter-B_Paste.gbp, bobcat-rak-stack-adapter-B_Silkscreen.gbo, bobcat-rak-stack-adapter-Edge_Cuts.gm1, bobcat-rak-stack-adapter-F_Cu.gtl, bobcat-rak-stack-adapter-F_Mask.gts, bobcat-rak-stack-adapter-F_Paste.gtp]
2026-10-23 stack-adapter: 70.5 mm panel (top-only rail) for JLC Standard PCBA; order notes
    Standard PCBA (forced by ENIG/gold fingers) needs >= 70 x 70 mm, and JLC-added rails would cover the
    finger edge, so the panel gets an 8 mm top rail only: 78.6 x 70.5 mm, fingers flush and bare on the
    bottom. DRC clean; gerber_check passes. README order section updated (Standard top, no remark).
    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
    [bobcat-rak-stack-adapter-panel-B_Cu.gbl, bobcat-rak-stack-adapter-panel-B_Mask.gbs, bobcat-rak-stack-adapter-panel-B_Paste.gbp, bobcat-rak-stack-adapter-panel-B_Silkscreen.gbo, bobcat-rak-stack-adapter-panel-Edge_Cuts.gm1, bobcat-rak-stack-adapter-panel-F_Cu.gtl, bobcat-rak-stack-adapter-panel-F_Mask.gts, bobcat-rak-stack-adapter-panel-F_Paste.gtp]
